Pavitra7/EdgeCaSCADe/docs/README.rst

Comet System on Chip (SoC)
=========================

Memory Map
----------

+---------------+----------------+------------------+----------------+
| Base          | Length         | Attributes       | Description    |
+===============+================+==================+================+
| 0x0000_0010   | 0x0000_0300    |                  | CLINT          |
+---------------+----------------+------------------+----------------+
| 0x0000_0310   | 0x0000_0480    |                  | UART           |
+---------------+----------------+------------------+----------------+
| 0x0003_0000   | ND             | EX, NI, C        | ROM + DRAM     |
+---------------+----------------+------------------+----------------+

*(EX: Executable, NI: Non-idempotent, C: Cached, ND: Not defined)*
