Pavitra7/EdgeCaSCADe/docs/demo_RTL.png

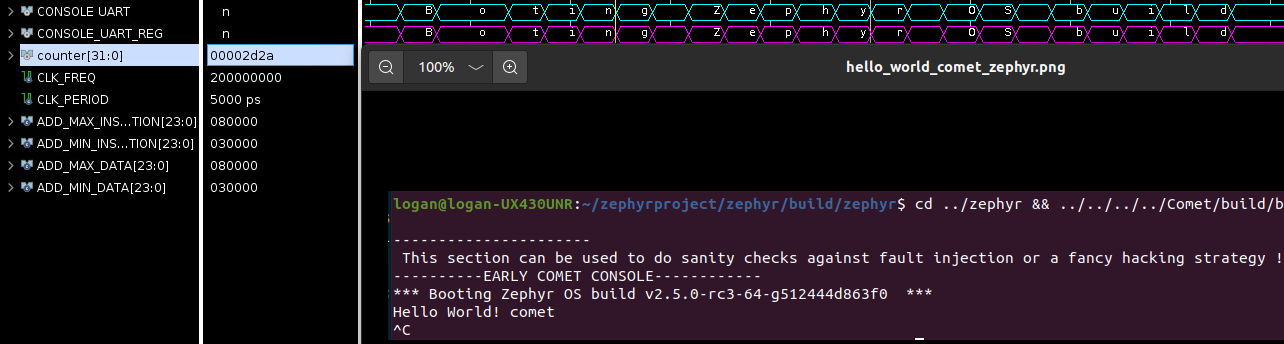
docs/demo_RTL.png
