Pavitra7/EdgeCaSCADe/docs/gitlab_memory_map.png

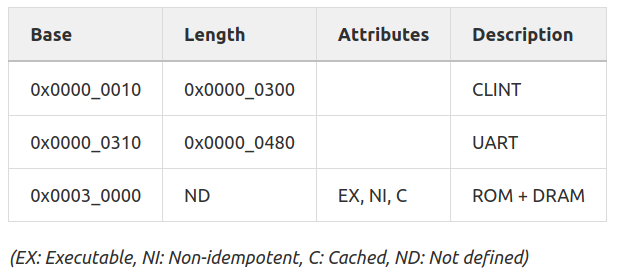
docs/gitlab_memory_map.png
