Pavitra7/EdgeCaSCADe/docs/philo_comet.png

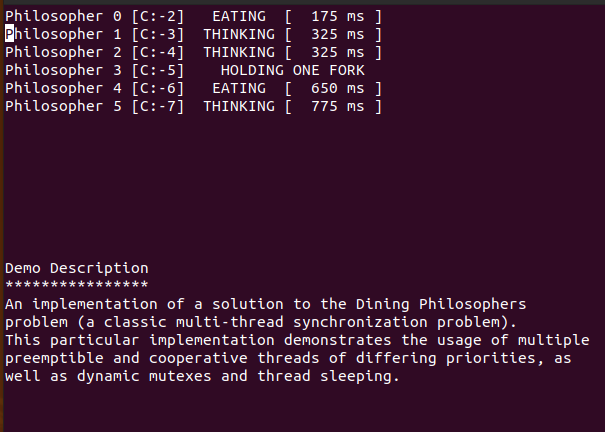
docs/philo_comet.png
