Pavitra7/EdgeCaSCADe/docs/synchro_comet_zephyr.png

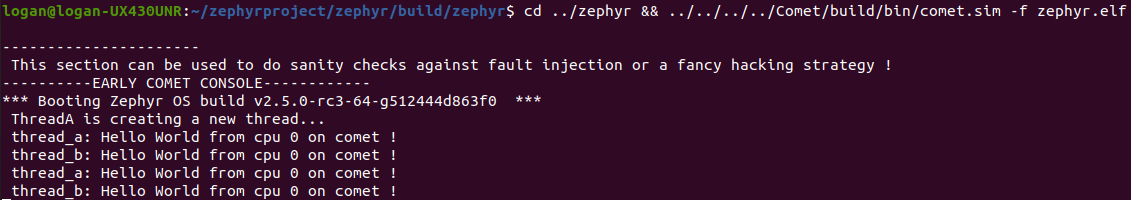
docs/synchro_comet_zephyr.png
